MalteBastelt/Wecker/Dokumentation/Latex/Ollenschlaeger_Doku_Wecker.pdf

# DIY: Herstellung eines personalisierten Weckers mit Mikrocontroller und mp3-Player

Malte Ollenschläger

Zusammenfassung—Dieses Dokument beschreibt die Herstellung eines personalisierten Weckers. Das beinhaltet die Erstellung eines Gehäuses und das Schreiben der Software für den Mikrocontroller. Auch die Bauteilauswahl und die Fertigung von Platinen sind in diesem Projekt inbegriffen. Das Ziel ist einerseits die Fertigung des Weckers, andererseits die Durchführung eines Projektes mit verschiedenen Aufgabenbereichen, um das hierbei Gelernte, in folgenden Projekten zu einer effizienteren Arbeitsweise umzusetzen. Dies betrifft sowohl inhaltliche als auch formelle Arbeitsschritte.

I. ZIELSETZUNG
D

IE Gesamtfunktion des Weckers soll sich aus mehreren Teilfunktionen zusammensetzen. Eine der grundlegenden Funktionen ist die Anzeige der Uhrzeit auf einem Display. Weiterhin wird das Datum durch die Zusammensetzung des aktuelle Monats als Wort und des Tages als Ordinalzahl angezeigt. Für den Monat Februar sollen Schaltjahre berücksichtig werden. Ein weiteres Symbol gibt an, ob der Alarm einoder ausgeschaltet ist. Das De- beziehungsweise Aktivieren des Alarms geschieht durch das Gedrückthalten eines Tasters, über den gleichzeitig bei kurzem Drücken die die Beleuchtung eingeschaltet werden kann. Die Implementierung der Weckfunktion sorgt bei eingeschaltetem Alarm dafür, dass zur konfigurierten Uhrzeit der mp3-Player gestartet und eine sich auf selbigem befindliche mp3-Datei über die verbauten Lautsprecher wiedergegeben wird. Beim nächsten Weckruf wird die darauf folgende Datei abgespielt.
Über ein Menü, das über das Bedienen eines zweiten Tasters zu erreichen ist, sind folgende Elemente einstellbar:
- Uhrzeit
- Weckzeit
- Datum
- Lautstärke
- Boombox
Innerhalb des Menüs findet die Navigation über einen Drehencoder statt. Wird der Menüpunkt Boombox ausgewählt, so kann über ein Cinch-Kabel eine externe Audio-Quelle angeschlossen werden und die darauf abgespielte Musik wird über die Lautsprecher des Weckers wiedergegeben.
Die Personalisierung des Weckers wird durch drei Eigenschaften erreicht. Die erste ist die Tatsache, dass die Weckmusik nach dem eigenen Geschmack angepasst werden kann, indem diese auf den mp3-Player kopiert wird. Die zweite personalisierte Eigenschaft ist, dass beispielsweise an Valentinstag und am Geburtstag der Person statt des Datums andere Bilder oder Texte eingeblendet werden. Der offensichtlichste Teil der Personalisierung liegt in der Herstellung des Gehäuses. In die Front des Weckers werden Motive gelasert zu denen


Abbildung 1: Hierarchie der Elementaren Bauteile des Weckers. Die Pfeilspitze zeigt in die Datenflussrichtung. Blau unterlegt sind die für den Benutzer nicht zugänglichen Bauteile im Gehäuse. Die unterste Zeile zeigt die Ein- und Ausgabeebene, worüber der Benutzer mit dem Wecker interagiert.

die Benutzerin einen persönlichen Bezug hat. Diese werden zusätzlich zum Display beleuchtet, wenn der entsprechende Taster betätigt wird. Als Vorlage für dieses Projekt diente ein ebenfalls selbst hergestellter Wecker, der auf der Internetseite www.wiesolator.de vorgestellt wurde.
Alle im Rahmen dieses Projekts erstellten Dateien sind unter www.github.com/MalteBastelt/Wecker zu finden.

II. HARDWARE

Dieser Abschnitt befasst sich mit der gesamten Hardware des Weckers. Hierzu wird in Teil II-A beschrieben, welche Bauteile benötigt werden. Der sich anschließende Teil II-B befasst sich mit der externen Beschaltung der Bauteile. Es folgt ein Abschnitt über die Pinbelegung am Mikrocontroller in II-C. Abschnitt II-D beschreibt die Ansteuerung des mp3-Players. In II-E wird auf die Planung und Fertigung der Platinen eingegangen. Weiterhin erläutert II-F die Herstellung des Gehäuses.

A. Bauteile

Der Schaltplan, der im Vorlageprojekt genutzt wurde, dient als Anhaltspunkt für die Hardware, die benötigt wird. Daraus wurde das Schaubild in Abb. 1 erstellt, um eine Übersicht der wichtigsten Bauteile zu erhalten. Eine Auflistung aller benötigter Bauteile ist in Tabelle I aufgeführt. Die benötigten Widerstände und Kondensatoren sind nicht aufgeführt, da diese den Datenblättern der jeweiligen Bauteile zu entnehmen sind.

Funktionseinheit | Bezeichnung
Buchsenleiste | EBLG-20-1-X
Display | EA DOGL128W-6
Displaybeleuchtung | EA LED68x51-W
Drehencoder | STEC11B
Lautsprecher | Visaton FR8-8
Leuchtdioden | DLE-0000397
Mikrocontroller | Atmega328P
mp3-Player | Intenso Music Walker
Plexiglas
Schaltnetzteil 5V/1A | goobay 54805
Spannungsregler 1,5VDC | LM317
Spannungsregler 3,3VDC | LM3940
Spanplatten
Schrauben
Muttern
Taster | MS 131 SW
Transistor | BC547C
Transparenzfolie
Uhrenquarz 32kHz | -
Verstärker | TDA7266

Tabelle I: Benötigte Bauteile. Notwendige Kondensatoren und Widerstände sind nicht angegeben. Diese sind in den jeweiligen Datenblättern zu finden.

B. Dimensionierung
Grundsätzlich wurden die in den Datenblättern empfohlenen Kondensatoren und Widerstände eingesetzt. Zum Entprellen der Taster sind in den entsprechenden Datenblättern keine Informationen vorhanden. Es werden Keramikkondensatoren der Größe C = 100nF genutzt. Bei dem Spannungsregler für den mp3-Player (LM317) muss eine individuelle Dimensionierung vorgenommen werden, da der Ausgang des gewählten Spannungsreglers variable Spannungen erzeugen kann. Die benötigte Versorgungsspannung beträgt 1, 5V . Nach der im zugehörigen Datenblatt [1] angegebenen Formel, kann für eine gewünschte Ausgangsspannung die Größe der benötigten Widerstände berechnet werden. Somit ergibt sich die Größe von R2 nach folgender Gleichung:

R2 = ( Vout

Vref

− 1)/(

1
R1
+ Iadj ) | (1)

Für den Ausgleichsstrom wurden 50µA und damit die Hälfte des Maximums angenommen. Dieser wird vom Spannungsregler so geregelt, dass Vref = 1, 25V gilt. Bei einer Wahl von R1 = 10kΩ ergibt sich für R2 ≈ 1, 3kΩ.
Zur Beleuchtung der beiden Bilder auf der Frontseite des Weckers wird je Bild eine Transistorschaltung (Abb. 2) benötigt. Diese wird durch ein Kontrollsignal vom Mikrocontroller, welches an die Basis des Transistors angeschlossen ist, gesteuert. Ein BC547C Transistor schaltet vier LEDs. Der Kollektorstrom von IC ist das Vierfache des Vorwärtsstroms einer LED IF = 20mA [2]:
IC = 4 · IF | (2a)
IC = 4 · 20mA = 80mA | (2b)


Abbildung 2: Transistorschaltung zur Ansteuerung von LEDs

Dies folgt aus der ersten Kirchhoff’schen Regel, wonach sich der Kollektorstrom gleichmäßig auf die vier LEDs aufteilt. Die Berechnung der Widerstände ergibt sich aus folgen Formeln:

RBasis ≤

UµC − UBE
IB

=

3, 3V − 0, 66V
5mA | ≈ 528Ω | (3)

RKollektor =

Ucc − ULED − UCE
IC

=

5V − 3, 6V − 0, 2V
80mA | ≈ 15Ω

(4)

Da der Mikrocontroller eine Versorgungsspannung von 3, 3V hat, ist das Steuersignal UµC ebenso groß. Die Basis-Emitter-Spannung UBE und die Kollektor-Emitter-Spannung UCE sowie der Basisstrom IB sind dem Datenblatt des BC547C entnommen [3]. Entsprechendes gilt für die an den LEDs abfallende Spannung. Nach den Berechnungen in den Gleichungen (2) bis (4) wurde der Basiswiderstand zu 440Ω und der Kollektorwiderstand zu 15Ω gewählt.

C. Pinbelegung Mikrocontroller

Da es für den Oszillator keine Auswahlmöglichkeiten bezüglich der Pinbelegung gibt, wurden ihm als erstes die entsprechenden Pins am Mikrocontroller zugewiesen. Hierfür ist kein Datenblatt vorhanden, weil er im Einzelhandel ohne exakte Artikelbeschreibung gekauft wurde. Die Pins für den Anschluss des Displays wurden so gewählt, dass alle nebeneinander liegen, damit das Layout der Platine erleichtert wird und lediglich gerade Leiterbahnen zwischen den Pins des Mikrocontrollers und dem betreffenden Steckverbinder erstellt werden müssen. Gleiches gilt für die Belegung der Pins zur Ansteuerung des mp3-Players.
Die Auswahl für die Belegung der Taster unterliegt lediglich der Einschränkung, dass die Taster (Licht und Drehencoder) einem anderen Interrupt zugeordnet werden als eine Drehung des Drehencoders. Dies führt zu einer vereinfachten Auswertung der Drehrichtung, siehe Abschnitt III-B.

Display | USB

3,5 mm Klinke On/Play

1
2
3

4
5
6

Abbildung 3: Pinbelegung mp3-Player

D. Ansteuerung mp3-Player

Um ein Bild davon zu bekommen, wie die Steuerung des mp3-Players funktioniert, wurde dieser zunächst aus seinem Gehäuse ausgebaut. Durch Testen wurde die Funktionsweise der benötigten Taster simuliert. In Abb. ?? ist eine Zeichnung des mp3-Players dargestellt, die zum näheren Verständnis des folgenden Textes herangezogen werden kann.
Der silberne Steuerknopf hat auf zwei gegenüberliegenden Seiten je 3 Kontakte. Darüber liegt rings um diesen Knopf unterhalb der Plastikabdeckung eine Massefläche. Wird der Knopf in eine bestimmte Richtung bewegt, so wird einer der 6 Pins auf Masse gezogen und daraus resultiert ein Steuersignal. Welches Ereignis durch die verschiedenen Pins ausgelöst wird, ist in Tabelle II dokumentiert. Zur Betätigung des Ein- und Ausschalters, der bei kurzem Drücken für Play/Pause genutzt wird, muss eine bestimmte der vier daran befindlichen Lötstellen auf das Level 1, 5V gehoben werden. Zwei Lötstellen befinden sich auf der Oberseite und zwei in Richtung Mitte der Platine. Von letzteren muss die Lötstelle, welche in Richtung der 3, 5mm-Klinken-Buchse liegt, auf 1, 5V angehoben werden. Um das 3, 3V Schaltsignal des Mikrocontrollers auf 1, 5V für den mp3-Player zu verringern, wurden 3 Dioden vom Typ 1N4448 in Reihe zwischen den Ausgang des Mikrocontrollers und den betreffenden Konnektor zum mp3-Player geschaltet. Über den Dioden fällt jeweils etwa 0, 6V ab, sodass 3, 3V − 3 · 0, 6V = 1, 5V an dem Taster anliegen, wenn der Pin des Mikrocontrollers auf 3, 3V gesetzt ist. Die Versorgungsspannung des mp3-Players wird über einen 1, 5V -DC/DC Spannungsregler zur Verfügung gestellt.
Pin | Level | Ereignis
1 | 0V | Song wechseln
3 | 0V | Lautstärke -
4 | 0V | Lautstärke +
On-1 | 1,5V | Ein/Aus, Play/Pause

Tabelle II: Tastenkombination für Auslösung verschiedener Ereignisse. Funktion von On-1 je nach Betätigungsdauer (lang,kurz).

E. Platinen

Die für dieses Projekt benötigten Platinen wurden mit KiCAD geplant und anschließend im FabLab der Friedrich-Alexander-Universität Erlangen-Nürnberg erstellt. Die erste Platine konnte nicht verwendet werden, da das ausgedruckte Layout nicht den tatsächlichen Dimensionen entsprach. Die

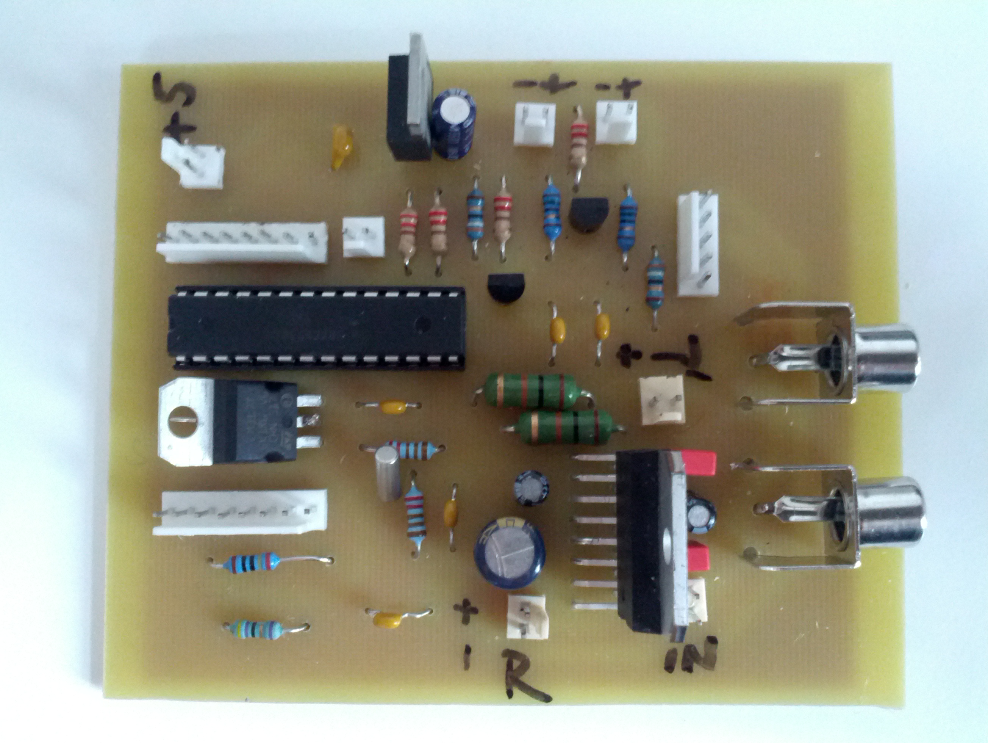
[picture p5: figure]

Abbildung 4: Hauptplatine.

Ursache hierfür liegt vermutlich im Export des Schaltplans in eine PDF-Datei. Korrekte Maße bleiben nur Erhalten, wenn in eine PostScript-Datei anstatt in ein PDF exportiert wird. Eine Platine ist für das Display und die zugehörigen Bauelemente (Kondensatoren, Widerstände) ausgelegt. Über einen Steckverbinder kann diese Platine mit der Hauptplatine verbunden werden, welche die anderen Bauelemente wie zum Beispiel den Mikrocontroller und den Audio-Verstärker enthält.
Für die Displayplatine wurden die Anschlüsse des Displays nicht direkt auf der Platine verlötet. Es wurden Buchsenleisten verlötet in welche das Display samt verlöteter Hintergrundbeleuchtung eingesteckt wird. Dies dient einerseits dazu, dass das Display zum Wechsel oder zur Reparatur ausgebaut werden kann; andererseits dazu, dass der Abstand zwischen Gehäuseinnenseite und Platine vergrößert wird. Dies ist notwendig, damit der Drehencoder, welcher auf der Platine befestigt wird, nicht zu weit nach vorne aus dem Gehäuse herausragt. Außerdem dient es der Herstellung einer kraftschlüssigen Verbindung zwischen Display und Gehäuse (siehe II-F). Für die Erstellung der Platine wurde eine Leiterbahnbreite von 0, 5mm gewählt, da genug Fläche vorhanden war.
Für die Hauptplatine wurde ebenfalls eine Leiterbahnbreite von 0, 5mm gewählt. Neben der Displayplatine wurden weitere Bauelemente per Steckverbinder mit der Hauptplatine verbunden. Diese sind:
- Lautsprecher
- Taster
- Drehencoder
- LED-Beleuchtung (Bilder)
- mp3-Player
Abbildung 4 zeig die bestückte Hauptplatine. Zur Identifikation der Bauteile können die in KiCAD erstellten Dokumente genutzt werden, die sich im GitHub-Verzeichnis befinden.
F. Gehäuse

In die vier Ecken der Platine werden Löcher gebohrt, ebenso im gleichen Abstandsmaß in die Front des Weckers. Anschließend kann die Platine per Schraube und Mutter von innen gegen das Gehäuse gedrückt werden, sodass das Display fixiert ist und durch die rechteckige Öffnung in der Front des Gehäuses betrachtet werden kann.

III. SOFTWARE

Um die gewünschten Inhalte auf dem LCD-Display anzuzeigen, müssen diese Elemente zunächst generiert werden. Dies geschah mittels Inkscape. Anschließend wurden diese Inhalte einen selbst geschriebenen Java-Programm zugeführt, welches in Abschnitt III-A beschrieben wird. Der zweite Abschnitt befasst sich mit dem umfangreicheren Code, der auf dem Mikrocontroller eingesetzt wird.

A. Bildkonversion

Für die Entwicklung eines Bildkonverters in Java wurde Eclipse genutzt. Ziel ist die Umwandlung von grafischen Dateien in Binärcode, also ein monochrom Bild. Anschließend sollen jeweils 8 Binärwerte/Pixel zu einer Hexadezimalzahl zusammengefasst werden.
Zunächst werden Dateien mit einzelnen Buchstaben, Symbolen und Bildern in Inkscape erstellt. In Schriftgröße 18 gibt ein zentrierter Großbuchstabe J die vertikale Position aller weiteren Buchstaben vor, da dies der höchste Buchstabe ist. Die erstellte Grafik wird als *.png exportiert und dem Java-Programm zugeführt. Dieses trägt den Namen Bildkonverter. Wird es geöffnet, sind drei Buttons und ein Eingabefeld zu sehen. Über Datei wählen wird das zu verarbeitende Bild ausgewählt. Die Umwandlung startet durch Klicken des entsprechenden Buttons. Zunächst wird durch Auswertung des Rotkanals jedes Pixels ein Binärwert erzeugt. Ist der Wert des Rotkanals größer oder gleich der angegebene Schwelle, so wird das entsprechende Pixel gesetzt. Ist es geringer als der Schwellwert, wird dieser Pixel auf null gesetzt. Anschließend werden jeweils 8 aufeinander folgende Pixel einer Spalte zu einem Hexadezimalwert zusammengefasst, um das Handling zu erleichtern. Wenn ein Bild eine Höhe von 16px hat und eine Breite von 3px, so werden 3 Mal zwei Hexadezimalwerte erzeugt. Diese sechs Werte werden in geschweiften Klammern ausgegeben, damit diese in einem Alphabet-Array im Code für den Mikrocontroller gespeichert werden können. Weiterhin wird eine Vorschau des Binärbildes angezeigt. So müssen die Daten nicht erst auf den Mikrocontroller überspielt und am LCD-Display angezeigt werden, um Fehler zu erkennen. Diese können beispielsweise durch Änderung des Schwellwertes oder durch das Setzen oder Löschen einzelner Pixel in dem Bild mittels Bildbearbeitungssoftware (zum Beispiel Paint) korrigiert werden. Zum Beenden des Konverters dient der Button Schließen. Die Ausgabe befindet sich nun in einer Datei mit dem Namen Konverter-output.txt in dem Ordner, in dem das Java-Programm gestartet wurde.
B. Atmel-Code

Der Code für den Mikrocontroller wurde zunächst in AtmelStudio 6.1 und anschließend in AtmelStudio 7.0 erstellt. Er setzt sich aus verschiedenen Dateien zusammen. Die Hauptaufgabe übernimmt eine Endlosschleife in der Main-Funktion der Datei EADOGL128.c. In EADOGL128_commands.c wurden die Befehle zur Ansteuerung des LCD-Displays implementiert. Um den mp3-Player und den Audio-Verstärker anzusprechen, werden die in mp3.c erstellten Funktionen genutzt. Nicht selbst geschriebener Code wurde in Form von Standardbibliotheken wie avr/io.h genutzt sowie in der Datei sbit.h [4], welche es ermöglicht, Pins wie Variablen ansprechen zu können.
EADOGL128.c: | Es | gibt | mehrere | Interrupt-Service-
Routinen, die Einfluss auf die ausgeführten Aktionen in der Main-Funktion nehmen. Im Normalzustand befindet sich der Mikrocontroller im sleep-Modus. Um in diesen einzutreten sind einige Vorbereitungen notwendig, die in der Funktion goodNight() implementiert sind. Das Verlassen des sleep-Modus geschieht durch eines von mehreren möglichen Interrupts. Hierzu zählen die Bedienung des Drehencoders und des Tasters sowie ein Timer-Overflow aufgrund der Zeitmessung mittels Uhrenquarz. Dieser Overflow findet ein Mal pro Sekunde statt. Wenn sich auf dem LCD-Display durch das Zeit-Update nichts ändern muss (Sekunde<60), wird der sleep-Modus erneut aktiviert.
Im Falle einer Benutzereingabe oder eines notwendigen Updates des LCD-Displays, wird die Funktion goodNight verlassen und das betreffende Ereignis wird abgearbeitet. Danach tritt der Mikrocontroller erneut in den sleep-Modus ein. Interrupt-Service Routinen (ISR):
Die ISR(PCINT0_vect) wird bei Interrupts an den Interrupt-Pins PCINT0 bis PCINT7 aufgerufen. Hierin wird überprüf, ob der Drehencoder oder der Taster gedrückt wurde und es wird entsprechende Flag auf true gesetzt. Somit wird zum Beispiel das Einschalten des Lichts in der main-Funktion eingeleitet. Würde die Drehung des Drehencoders im gleichen Interrupt erfasst werden, so müsste der letzte bekannte Status des Drehencoders gespeichert werden, damit überprüft werden kann, ob eine Änderung stattgefunden hat, oder lediglich ein Taster bedient wurde. Durch die Zuweisung der Signale, die bei einer Drehung verändert werden an eine andere ISR (PCINT2_vect), kann dieser Schritt eingespart werden. Die ISR (PCINT2_vect) vergleicht den Status der beiden betreffenden Signale. Die Drehrichtung lässt sich daraus ermitteln, ob beide Signale gleich

Status(P INA) = Status(P INC) = (high Y low) (5)

oder unterschiedlich

Status(P INA) 6= Status(P INC) | (6)

sind [5]. Je nach Ergebnis dieses Vergleichs wird bei einer detektierten Rechtsdrehung eine Zählvariable inkrementiert sowie bei Linksdrehung dekrementiert. Diese muss bei Abruf auf null zurückgesetzt werden.
Bei eingeschalteter Beleuchtung bewirken alle Benutzereingaben eine Verlängerung der Leuchtdauer so, als ob der Taster für die Beleuchtung zu diesem Zeitpunkt betätigt wurde. Die dritte ISR(TIMER2_OVF_vect) wird aufgerufen, wenn ein Overflow in dem vom Uhrenquarz getakteten Counter stattfindet. Da ein 8-bit Timer mit einem Prescaler von 128 zum Inkrementieren des Counters genutzt wird, und der Quarz mit einer Frequenz von 32768 Hz schwingt, findet dieser

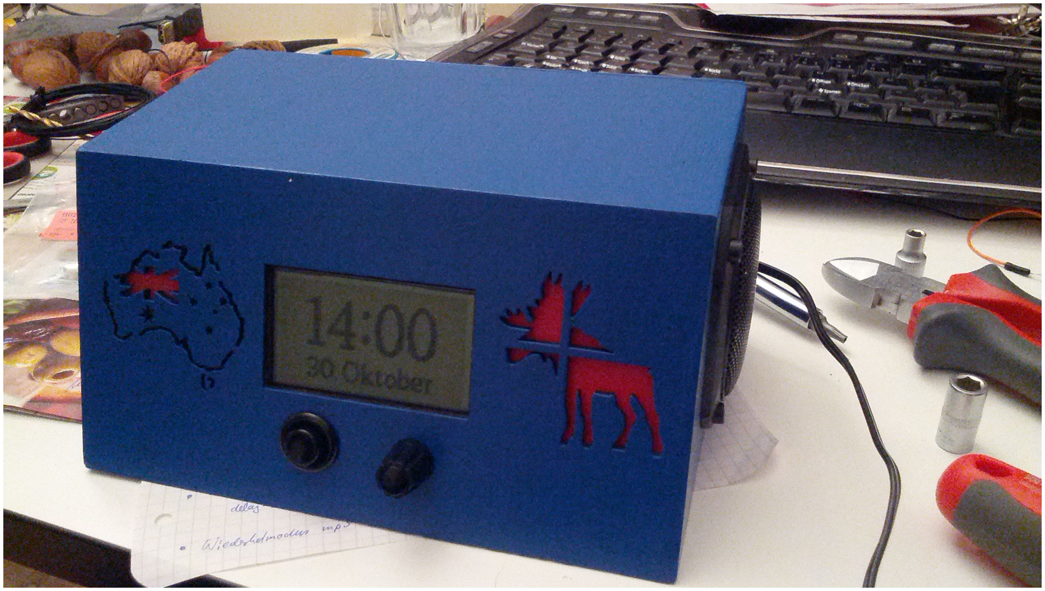
[picture p6: figure]

Abbildung 5: Wecker bei ausgeschalteter Beleuchtung

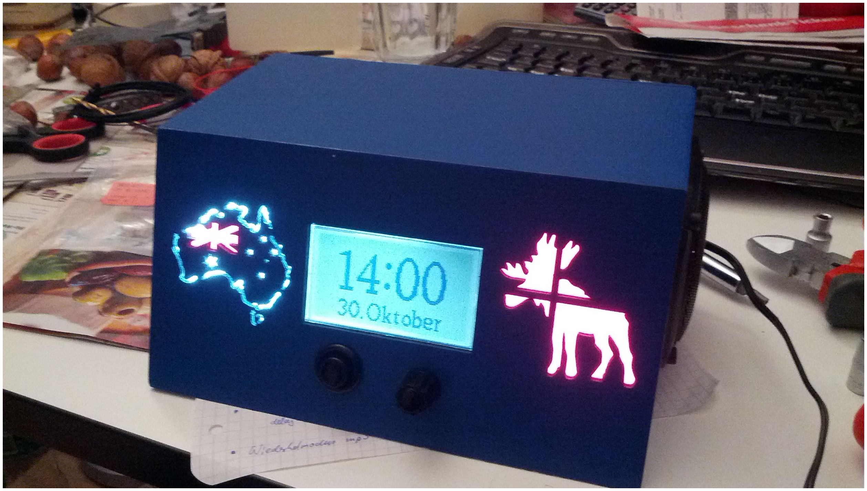
[picture p7: figure]

Abbildung 6: Wecker bei eingeschalteter Beleuchtung

Overflow ein Mal pro Sekunde statt. Hierbei wird die Variable sekunde um eins inkrementiert. Wenn diese Variable den Wert 59 übersteigt, wird ein Flag gesetzt, welches das Update der Minute und gegebenenfalls der Stunde sowie des Datums in der main-Funktion einleitet.
Eine vierte ISR(TIMER0_OVF_vect) wird genutzt um die Dauer eines Tastendrucks zu ermitteln. Dieser Timer kann mit der Funktion start_btnPress() aktiviert werden und mit stop_btnPress gestoppt werden. Die Dauer des Tastendrucks ist dann in der globalen Variablen btn_press_duration gespeichert und kann ausgelesen werden. Bei langem Drücken des Drehencoders wird das Menü aufgerufen. Weiterhin ermöglich dies, dass der Taster für das Licht bei kurzem Drücken zum Einschalten der Beleuchtung und bei langem Drücken zum Ein-/Ausschalten des Alarms führt.

IV. BEDIENUNG

Die Abbildungen 5 und 6 zeigen den erstellten Wecker. Unterhalb des Displays befindet sich rechts der Drehencoder und links der Taster. An der rechten Seite des Gehäuses ist ein Lautsprecher zu erkennen, ein identischer Lautsprecher ist auf der linken Seite verbaut.

A. Alarm
Um den Alarm ein- oder auszuschalten wird der Taster für mindestens 1, 5s gedrückt. Ausschalten des Alarms sowie stoppen des Weckrufs geschieht durch Betätigung des Tasters von 1, 5s oder mehr. Während des Weckrufs ist es außerdem möglich, in den snooze-Modus zu wechseln. Dies geschieht durch kurzes Drücken des Tasters oder Drehen des Drehencoders. Ein erneuter Weckeruf wird nach der im Menü eingestellten Snoozedauer (in Minuten) gestartet. Erneutes snoozen ist nicht möglich und der Weckruf muss über ein 1, 5-sekundiges Drücken des Tasters ausgeschaltet werden.
B. Menü
Das Menü kann über ein langes Drücken des Drehencoders aufgerufen werden. Navigiert wird über die Drehung desselben. Soll ein Punkt im Menü aufgerufen wird, so muss die Auswahl durch kurzes Drücken auf den Drehencoder getätigt werden. In Untermenüs wie beispielsweise der Uhrzeiteinstellung wird ebenfalls durch eine Drehung navigiert. Soll zum Beispiel die Stunde verändert werden, muss die Markierung über das entsprechende Element navigiert werden. Nach einer Bestätigung durch erneut kurzes Drücken ändert sich das Navigationssymbol und die Stunde der Uhrzeit kann verändert werden. Durch erneutes Drücken des Drehencoders wird dieser Modus verlassen. Das Untermenü kann über den angezeigten Haken verlassen werden.
C. Lautstärke
Für die Einstellung der Lautstärke des Weckrufs muss der entsprechende Unterpunkt im Menü aufgerufen werden. Daraufhin werden Verstärker und mp3-Player eingeschaltet. Letzterer benötigt etwa zehn Sekunden. Während dieser Zeit erscheint der Schriftzug „Bitte warten“. Die Musik geht an und anstatt des Schriftzugs erscheint ein Lautsprecher-Symbol. Die Lautstärke kann nun mittels Drehencoder verstellt werden.
D. Boombox
Bei Auswahl des Menüpunktes Boombox, wird der Verstärker eingeschaltet. Nun kann über die Cinch-Buchsen und ein entsprechendes Kabel (z.B. 3, 5mm-Klinke ↔ Cinch) eine externe Audioquelle wie ein Handy oder Laptop angeschlossen werden. Dessen Audiosignal wird dann über die Lautsprecher wiedergegeben.

LITERATUR

[1] 1.2 V to 37 V adjustable voltage regulators, STMicroelectronics
Data Sheet 2154, Rev. 19, Mär. 2014. [Online]. Available: http://www.st.com/web/en/resource/technical/document/datasheet/CD00000455.pdf
[2] 334-15/X2C1-1UWB, | Everlight | Technical | Data | Sheet,
Rev. | 2, | Nov. | 2008. | [Online]. | Available: | http://cdn-
reichelt.de/documents/datenblatt/A500/334-15-X2C1-1UWB.pdf
[3] SMALL | SIGNAL | NPN | TRANSISTORS, | STMicroelec-
tronics | | Std., | Jan. | 2003. | [Online]. | Available:
http://pdf.datasheetcatalog.com/datasheet/stmicroelectronics/8854.pdf
[4] AvrFreaks. | (2015, | Dezember) | Sbit.h. | [Online]. | Available:
http://www.avrfreaks.net/sites/default/files/SBIT.H
[5] 11mm Size Metal Shaft Type, ALPS Datasheet. [Online]. Available: http://cdn-reichelt.de/documents/datenblatt/B400/STEC11B.pdf
V. FAZIT
Bei der Erstellung des PCB-Layouts wurde zu Beginn nicht durchgängig die Anordnung der Bauteile auf dem Schaltplan beachtet. Somit kommt es zu viele Kreuzungen der Leiterbahnen. Eine Vorsortierung in Bauteilgruppen erleichtert das Routing und ist deshalb ratsam.
