MalteBastelt/Wecker/Dokumentation/Latex/Grafiken/mp3Player-eps-converted-to.pdf

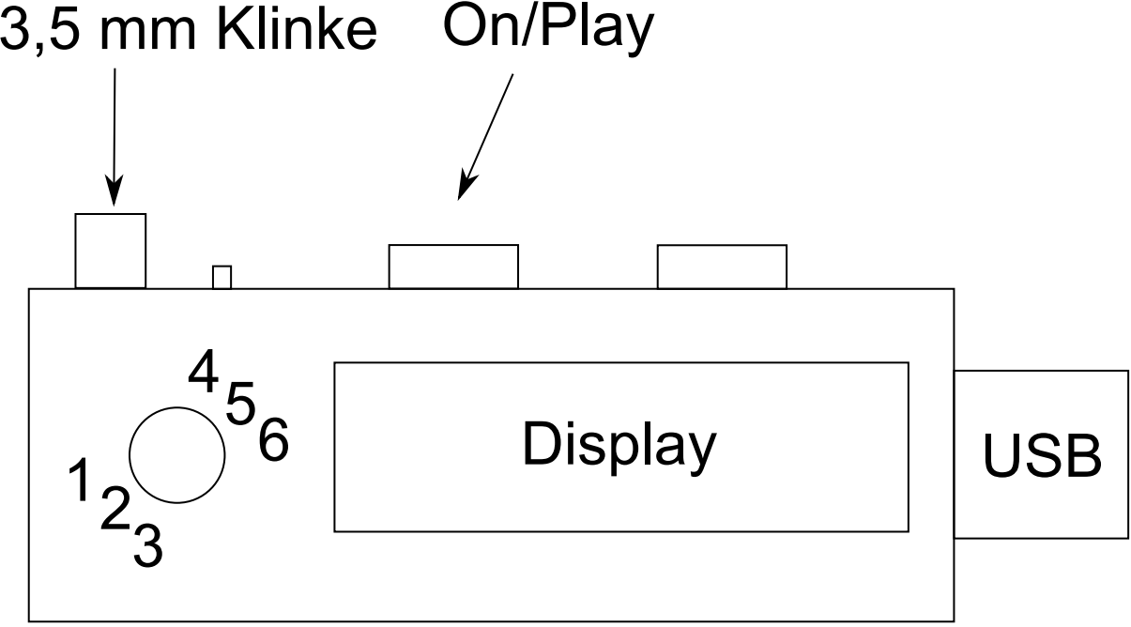
[picture p8: figure]
Display; USB; 3,5 mm Klinke On/Play
