MalteBastelt/Wecker/Bildkonverter/links.bmp

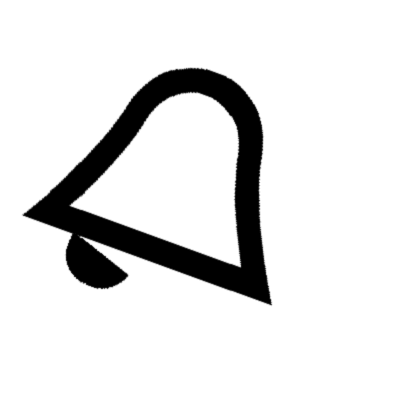
Bildkonverter/links.bmp
