MalteBastelt/Wecker/Bildkonverter/rechts.bmp

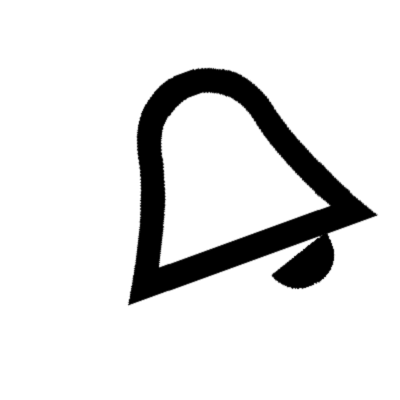
Bildkonverter/rechts.bmp
