MalteBastelt/Wecker/Bildkonverter/rose1.gif

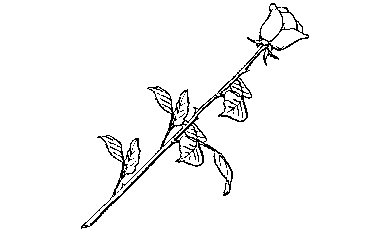
Bildkonverter/rose1.gif
