MalteBastelt/Wecker/Bildkonverter/rose2.jpg

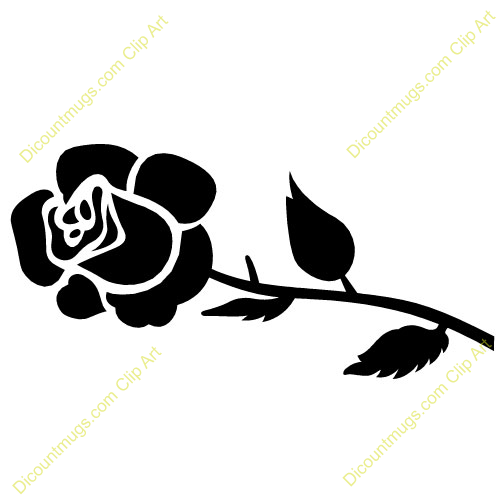
Bildkonverter/rose2.jpg
