MalteBastelt/Wecker/Bildkonverter/rose3.1.png

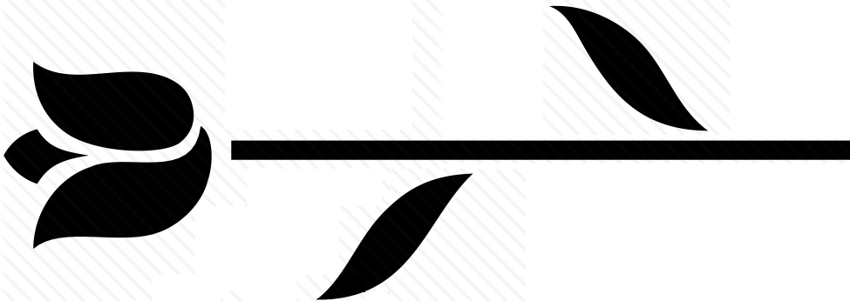
Bildkonverter/rose3.1.png
