MalteBastelt/Wecker/Bildkonverter/rose3.png

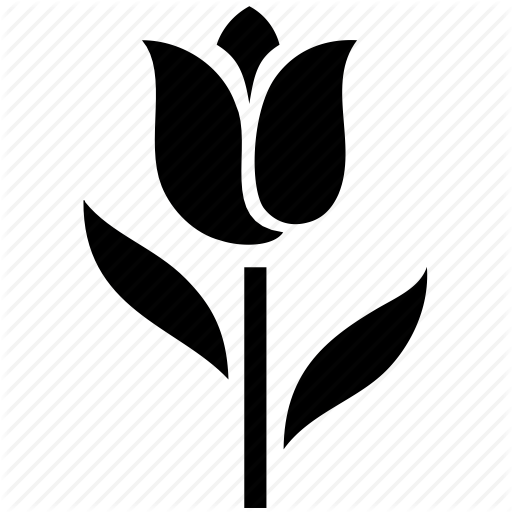
Bildkonverter/rose3.png
