MalteBastelt/Wecker/Dokumentation/Latex/Grafiken/mp3Player.png

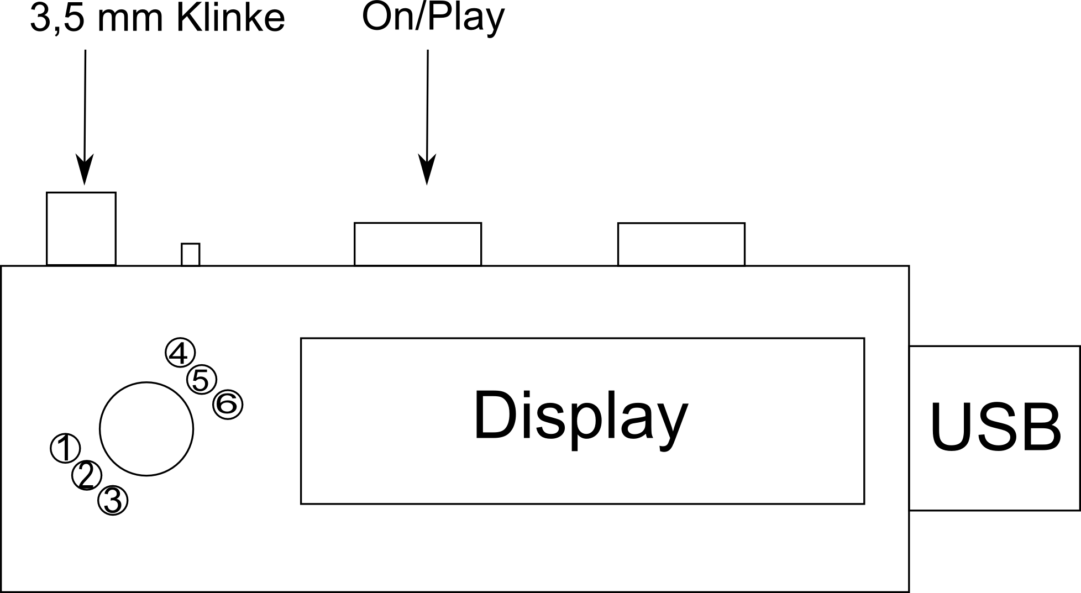
Dokumentation/Latex/Grafiken/mp3Player.png
