MalteBastelt/Wecker/KiCAD/Hauptplatine2/Wecker-B.Cu.pdf

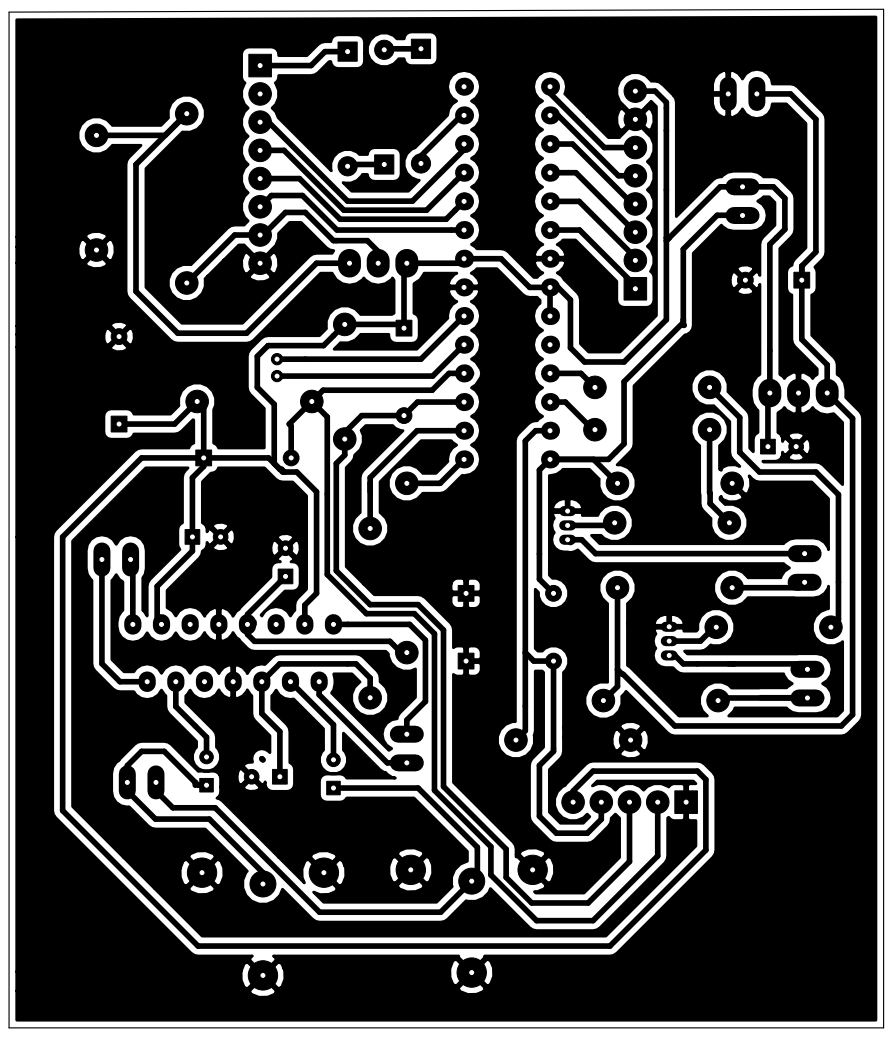
[picture p16: page 1]
