MalteBastelt/Wecker/KiCAD/Hauptplatine2/Wecker-F.Cu.pdf

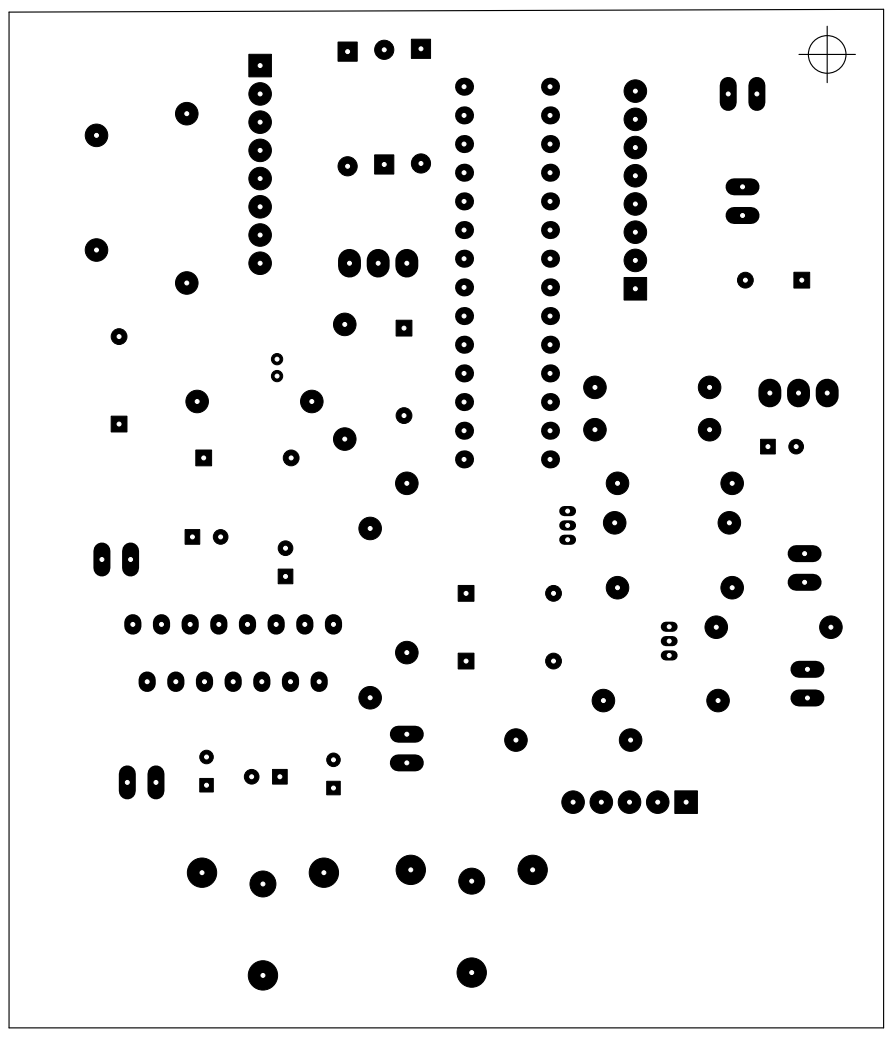
[picture p17: page 1]
