MalteBastelt/Wecker/KiCAD/Hauptplatine2/Wecker-F.SilkS.pdf

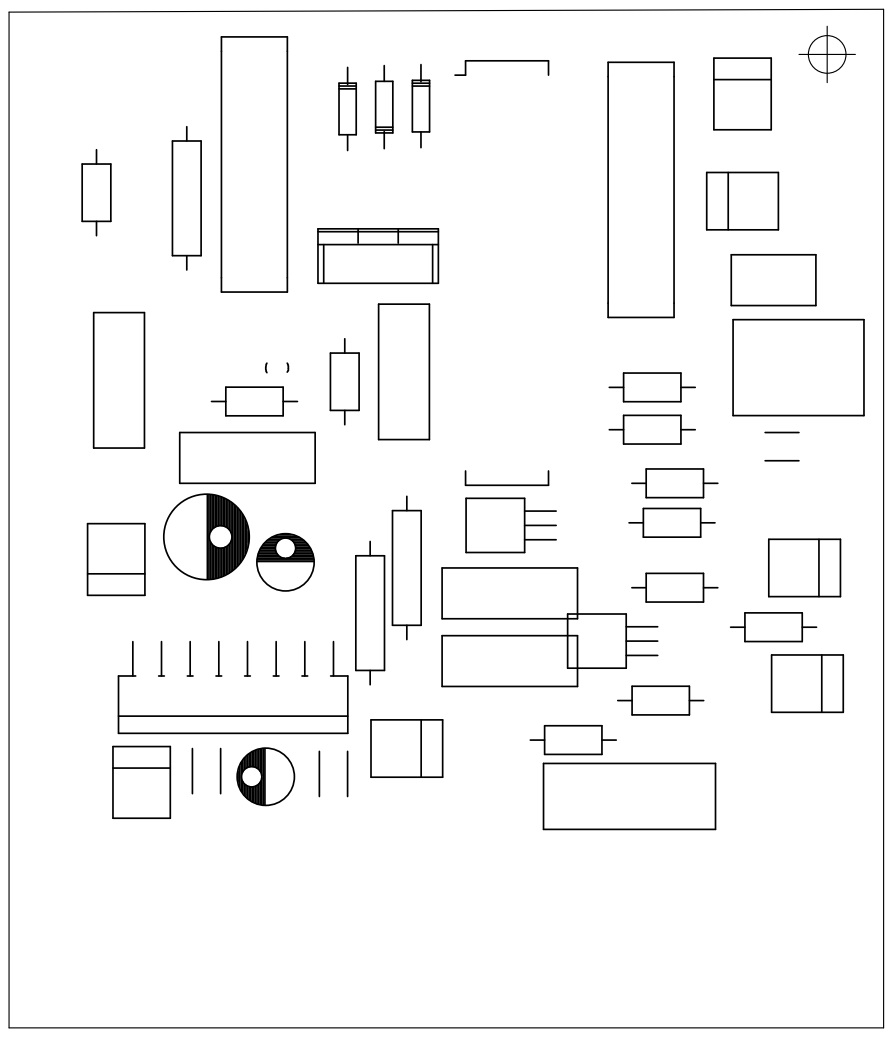
[picture p18: page 1]
