MalteBastelt/Wecker/KiCAD/Displayplatine/Display.kicad_pcb

## KiCad design KiCAD/Displayplatine/Display.kicad_pcb (2015-12-03)

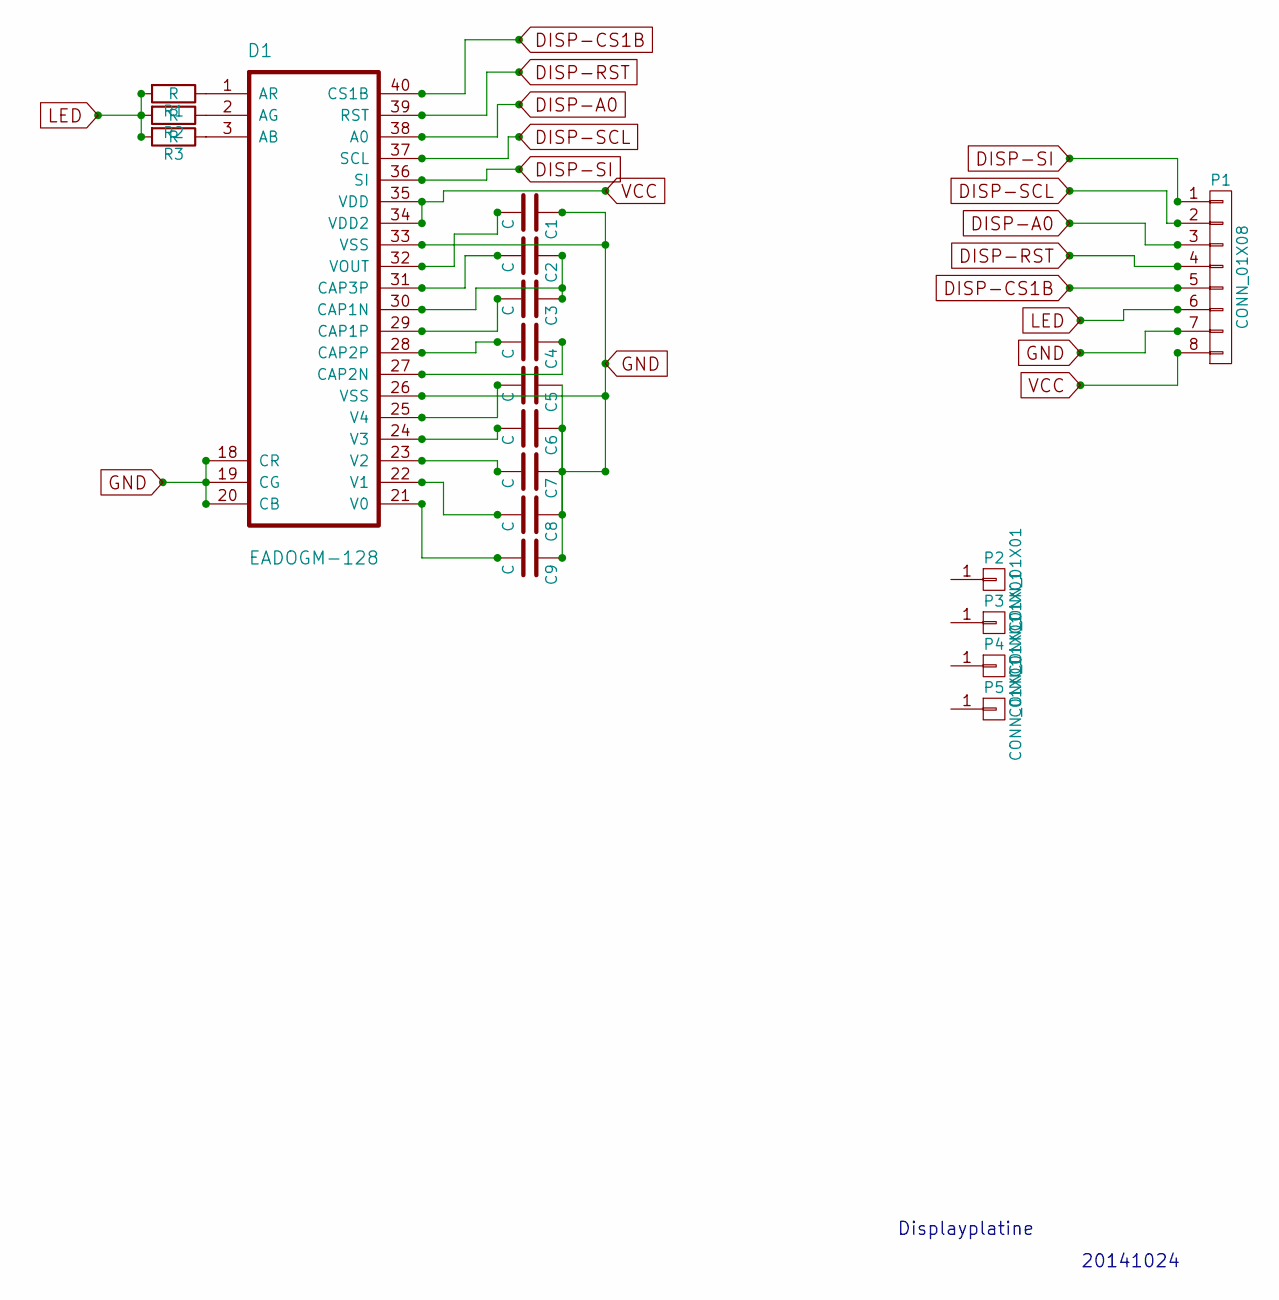
[picture p19: schematic Display.sch]

Parts:
C1, C2, C3, C4, C5, C6, C7, C8, C9: C; C_Disc_D7.5_P5
D1: EADOGM-128; EADOG128
P1: CONN_01X08; Pin_Header_Straight_1x08
P2, P3, P4, P5: CONN_01X01; Pin_Header_Straight_1x01
R1, R2, R3: R; Resistor_Horizontal_RM10mm

Connections:
D1: D1.36 (SI), P1.1
D2: D1.37 (SCL), P1.2
D3: D1.38 (A0), P1.3
D4: D1.39 (RST), P1.4
D5: D1.40 (CS1B), P1.5
GND: C1.1, C5.1, C6.1, C7.1, C8.1, C9.1, D1.18 (CR), D1.19 (CG), D1.20 (CB), D1.26 (VSS), D1.33 (VSS), P1.7
LED: P1.6, R1.2, R2.2, R3.2
unnamed: C1.2, D1.32 (VOUT)
unnamed: C2.1, C3.1, D1.30 (CAP1N)
unnamed: C2.2, D1.31 (CAP3P)
unnamed: C3.2, D1.29 (CAP1P)
unnamed: C4.1, D1.27 (CAP2N)
unnamed: C4.2, D1.28 (CAP2P)
unnamed: C5.2, D1.25 (V4)
unnamed: C6.2, D1.24 (V3)
unnamed: C7.2, D1.23 (V2)
unnamed: C8.2, D1.22 (V1)
unnamed: C9.2, D1.21 (V0)
unnamed: D1.1 (AR), R1.1
unnamed: D1.2 (AG), R2.1
unnamed: D1.3 (AB), R3.1
VCC: D1.34 (VDD2), D1.35 (VDD), P1.8

Notes on the sheet:
Displayplatine
20141024

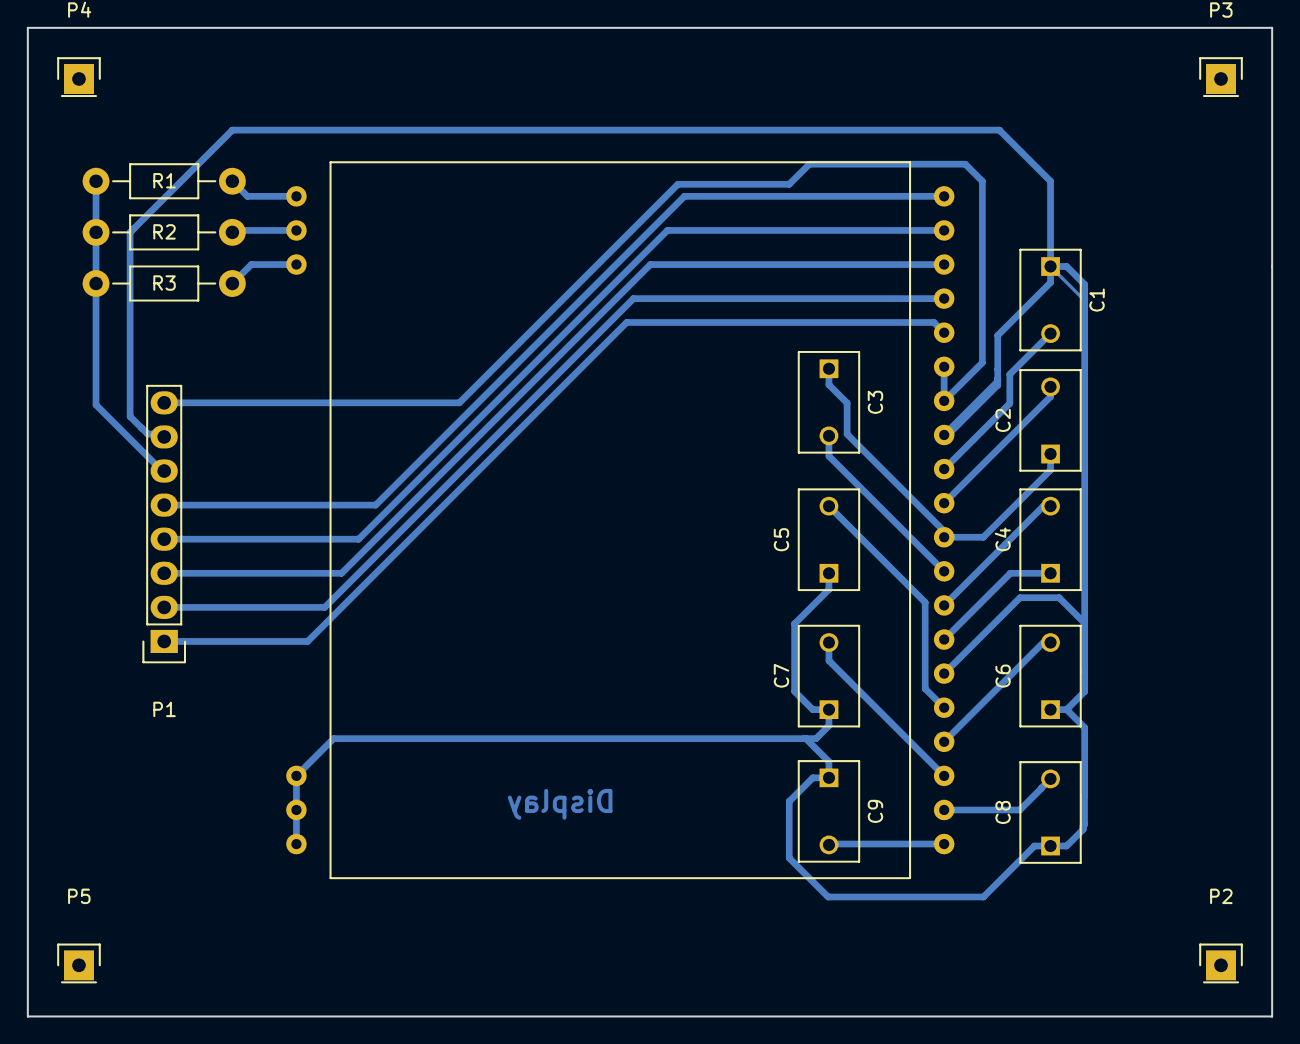
[picture p20: board Display.kicad_pcb from above]

Board: 2 copper layers, 92.7 x 73.7 mm, 18 parts (0 on the bottom side), 22 nets.
