MalteBastelt/Wecker/KiCAD/Hauptplatine2/Wecker.kicad_pcb

## KiCad design KiCAD/Hauptplatine2/Wecker.kicad_pcb (2015-12-03)

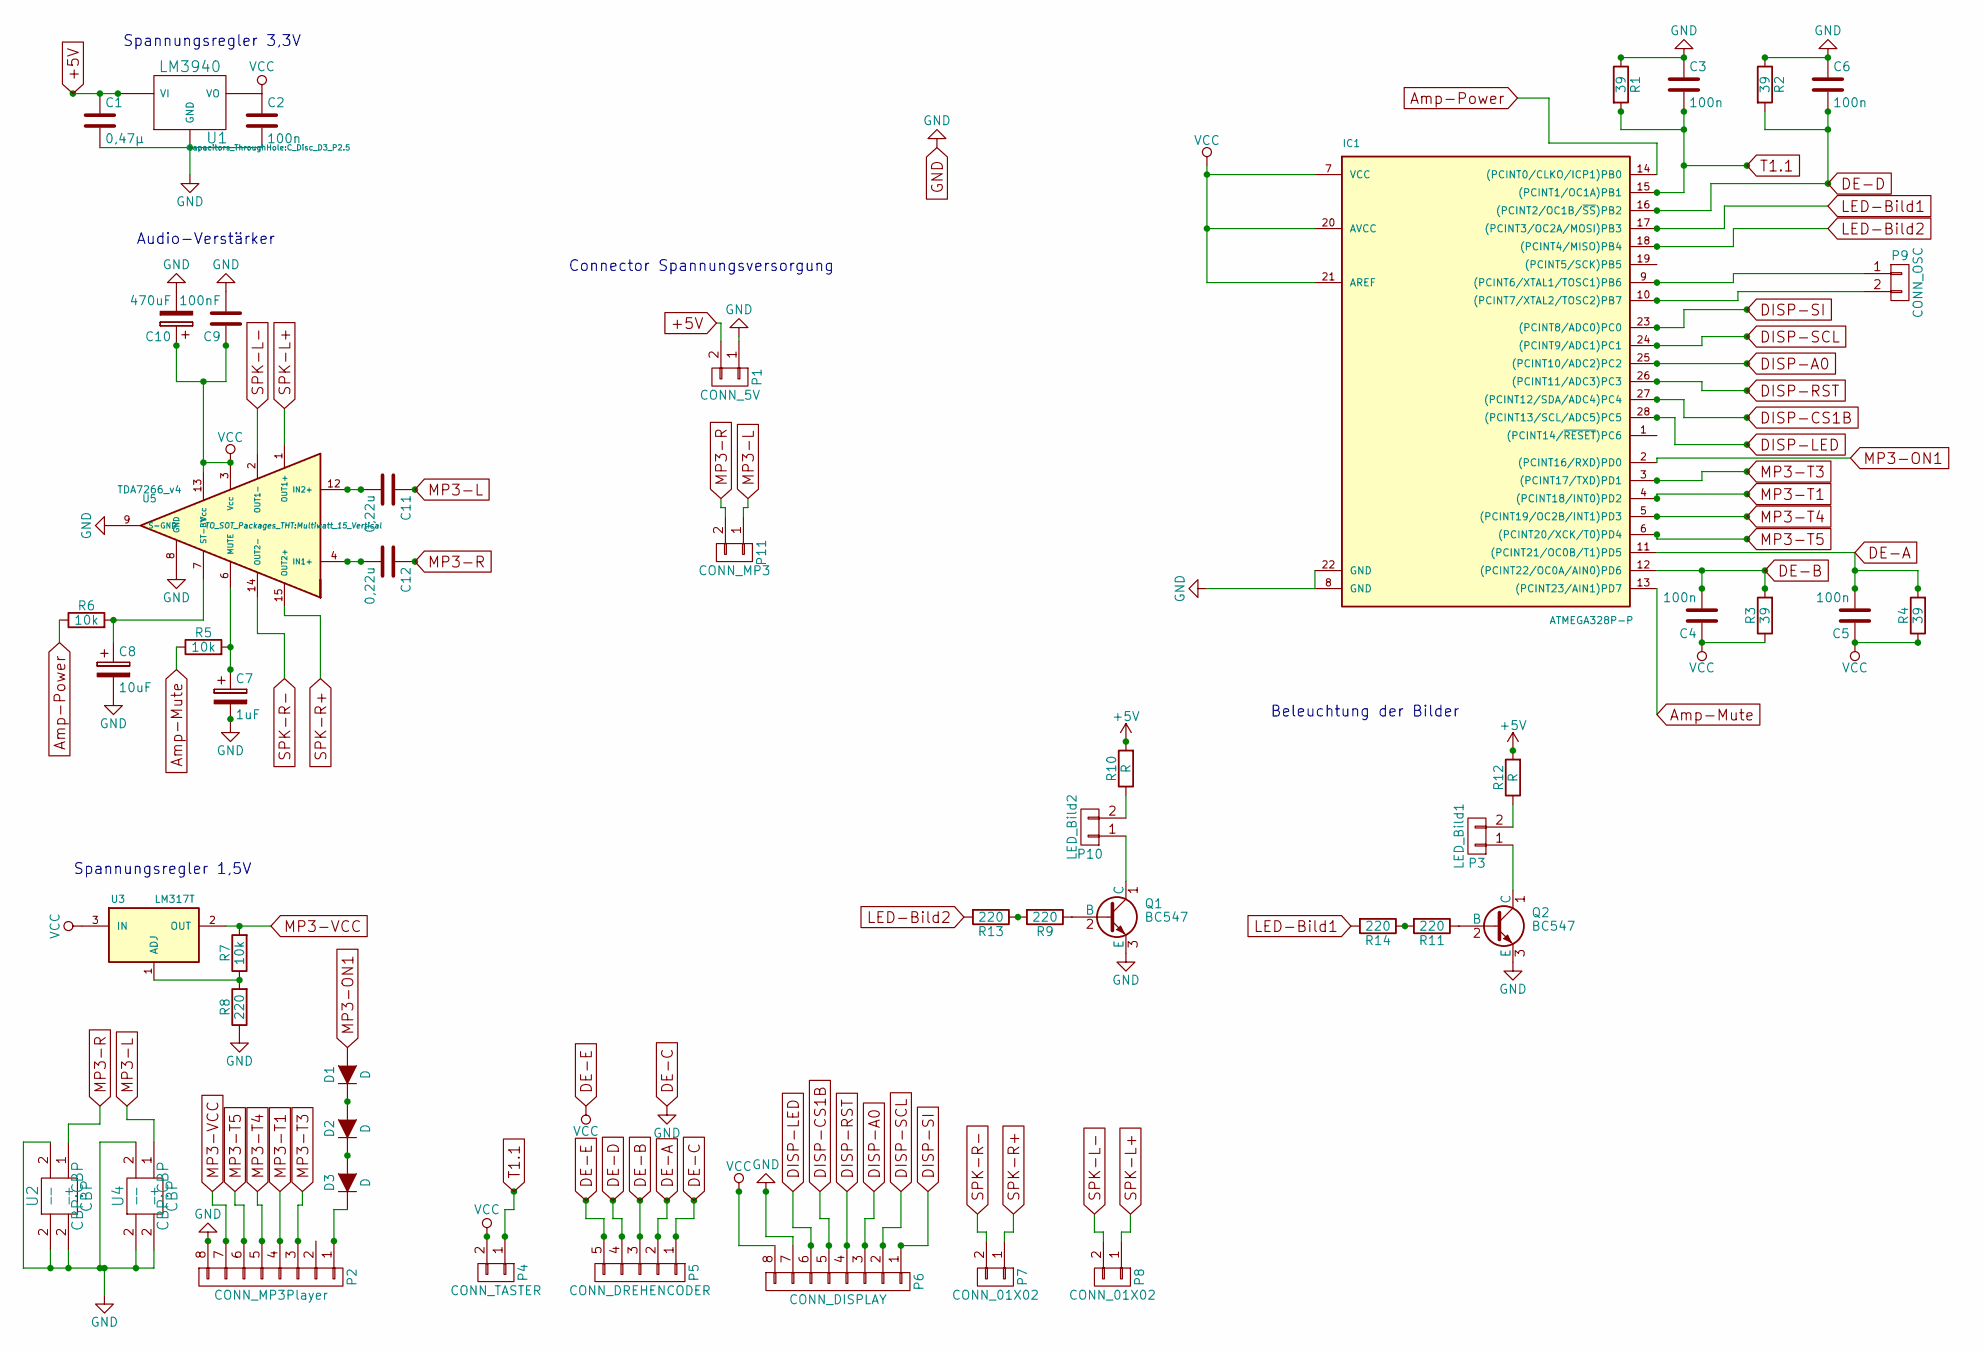
[picture p21: schematic Wecker.sch]

Parts:
C1: 0,47µ; C_Disc_D7.5_P5
C2: 100n; C_Disc_D3_P2.5
C3, C4, C5, C6: 100n; C_Disc_D12_P7.75
C7: 1uF; C_Radial_D5_L6_P2.5
C8: 10uF; C_Radial_D5_L6_P2.5
C9: 100nF; C_Disc_D12_P7.75
C10: 470uF; C_Radial_D7.5_L11.2_P2.5
C11, C12: 0,22u; C_Rect_L4_W2.5_P2.5
D1, D2, D3: D; Diode_DO-35_SOD27_Horizontal_RM10
IC1: ATMEGA328P-P; DIP-28_W7.62mm
P1: CONN_5V; PINHEAD1-2
P2: CONN_MP3Player; Wafer_Vertical22.5x5.8x7RM2.5-8
P3: LED_Bild1; PINHEAD1-2
P4: CONN_TASTER; PINHEAD1-2
P5: CONN_DREHENCODER; Wafer_Vertical15x5.8x7RM2.5-5
P6: CONN_DISPLAY; Wafer_Vertical22.5x5.8x7RM2.5-8
P7, P8: CONN_01X02; PINHEAD1-2
P9: CONN_OSC; Crystal_Round_Vertical_2mm
P10: LED_Bild2; PINHEAD1-2
P11: CONN_MP3; PINHEAD1-2
Q1, Q2: BC547; TO-92_Horizontal2_Inline_Narrow_Oval
R1, R2, R3, R4: 39; Resistor_Horizontal_RM10mm
R5, R6, R7: 10k; Resistor_Horizontal_RM15mm
R8, R9, R11, R13, R14: 220; Resistor_Horizontal_RM10mm
R10, R12: R; Resistor_Horizontal_RM10mm
U1: LM3940; TO-220
U2, U4: CBP
U3: LM317T; TO-220
U5: TDA7266_v4; Multiwatt_15_Vertical

Connections:
+5V: C1.1, P1.2, R10.2, R12.2, U1.1 (VI)
Amp-Mute: IC1.13 ((PCINT23/AIN1)PD7), R5.1
Amp-Power: IC1.14 ((PCINT0/CLKO/ICP1)PB0), R6.1
DE-A: C5.2, IC1.11 ((PCINT21/OC0B/T1)PD5), P5.2, R4.2
DE-B: C4.2, IC1.12 ((PCINT22/OC0A/AIN0)PD6), P5.3, R3.2
DE-C: C1.2, C2.2, C3.1, C6.1, C7.2, C8.2, C9.2, C10.2, IC1.8 (GND), IC1.22 (GND), P1.1, P2.8, P5.1, P6.7, Q1.3 (E), Q2.3 (E), R1.1, R2.1, R8.1, U1.2 (GND), U2.2 (-), U4.2 (-), U5.8 (GND), U5.9 (S-GND)
DE-D: C6.2, IC1.16 ((PCINT2/OC1B/~SS~)PB2), P5.4, R2.2
DE-E: C2.1, C4.1, C5.1, C9.1, C10.1, IC1.7 (VCC), IC1.20 (AVCC), IC1.21 (AREF), P4.2, P5.5, P6.8, R3.1, R4.1, U1.3 (VO), U3.3 (IN), U5.3 (Vcc), U5.13 (Vcc)
DISP-A0: IC1.25 ((PCINT10/ADC2)PC2), P6.3
DISP-CS1B: IC1.27 ((PCINT12/SDA/ADC4)PC4), P6.5
DISP-LED: IC1.28 ((PCINT13/SCL/ADC5)PC5), P6.6
DISP-RST: IC1.26 ((PCINT11/ADC3)PC3), P6.4
DISP-SCL: IC1.24 ((PCINT9/ADC1)PC1), P6.2
DISP-SI: IC1.23 ((PCINT8/ADC0)PC0), P6.1
LED-Bild1: IC1.17 ((PCINT3/OC2A/MOSI)PB3), R14.2
LED-Bild2: IC1.18 ((PCINT4/MISO)PB4), R13.2
MP3-L: C11.1, P11.1, U4.1 (+)
MP3-ON1: D1.2 (A), IC1.2 ((PCINT16/RXD)PD0)
MP3-R: C12.1, P11.2, U2.1 (+)
MP3-T1: IC1.4 ((PCINT18/INT0)PD2), P2.4
MP3-T3: IC1.3 ((PCINT17/TXD)PD1), P2.3
MP3-T4: IC1.5 ((PCINT19/OC2B/INT1)PD3), P2.5
MP3-T5: IC1.6 ((PCINT20/XCK/T0)PD4), P2.6
MP3-VCC: P2.7, R7.2, U3.2 (OUT)
unnamed: C7.1, R5.2, U5.6 (MUTE)
unnamed: C8.1, R6.2, U5.7 (ST-BY)
unnamed: C11.2, U5.12 (IN2+)
unnamed: C12.2, U5.4 (IN1+)
unnamed: D1.1 (K), D2.2 (A)
unnamed: D2.1 (K), D3.2 (A)
unnamed: D3.1 (K), P2.1
unnamed: IC1.9 ((PCINT6/XTAL1/TOSC1)PB6), P9.1
unnamed: IC1.10 ((PCINT7/XTAL2/TOSC2)PB7), P9.2
unnamed: P3.1, Q2.1 (C)
unnamed: P3.2, R12.1
unnamed: P10.1, Q1.1 (C)
unnamed: P10.2, R10.1
unnamed: Q1.2 (B), R9.1
unnamed: Q2.2 (B), R11.1
unnamed: R7.1, R8.2, U3.1 (ADJ)
unnamed: R11.2, R14.1
unnamed: R9.2, R13.1
SPK-L+: P8.1, U5.1 (OUT1+)
SPK-L-: P8.2, U5.2 (OUT1-)
SPK-R+: P7.1, U5.15 (OUT2+)
SPK-R-: P7.2, U5.14 (OUT2-)
T1.1: C3.2, IC1.15 ((PCINT1/OC1A)PB1), P4.1, R1.2

Notes on the sheet:
Spannungsregler 3,3V
Audio-Verstärker
Spannungsregler 1,5V
Connector Spannungsversorgung
Beleuchtung der Bilder

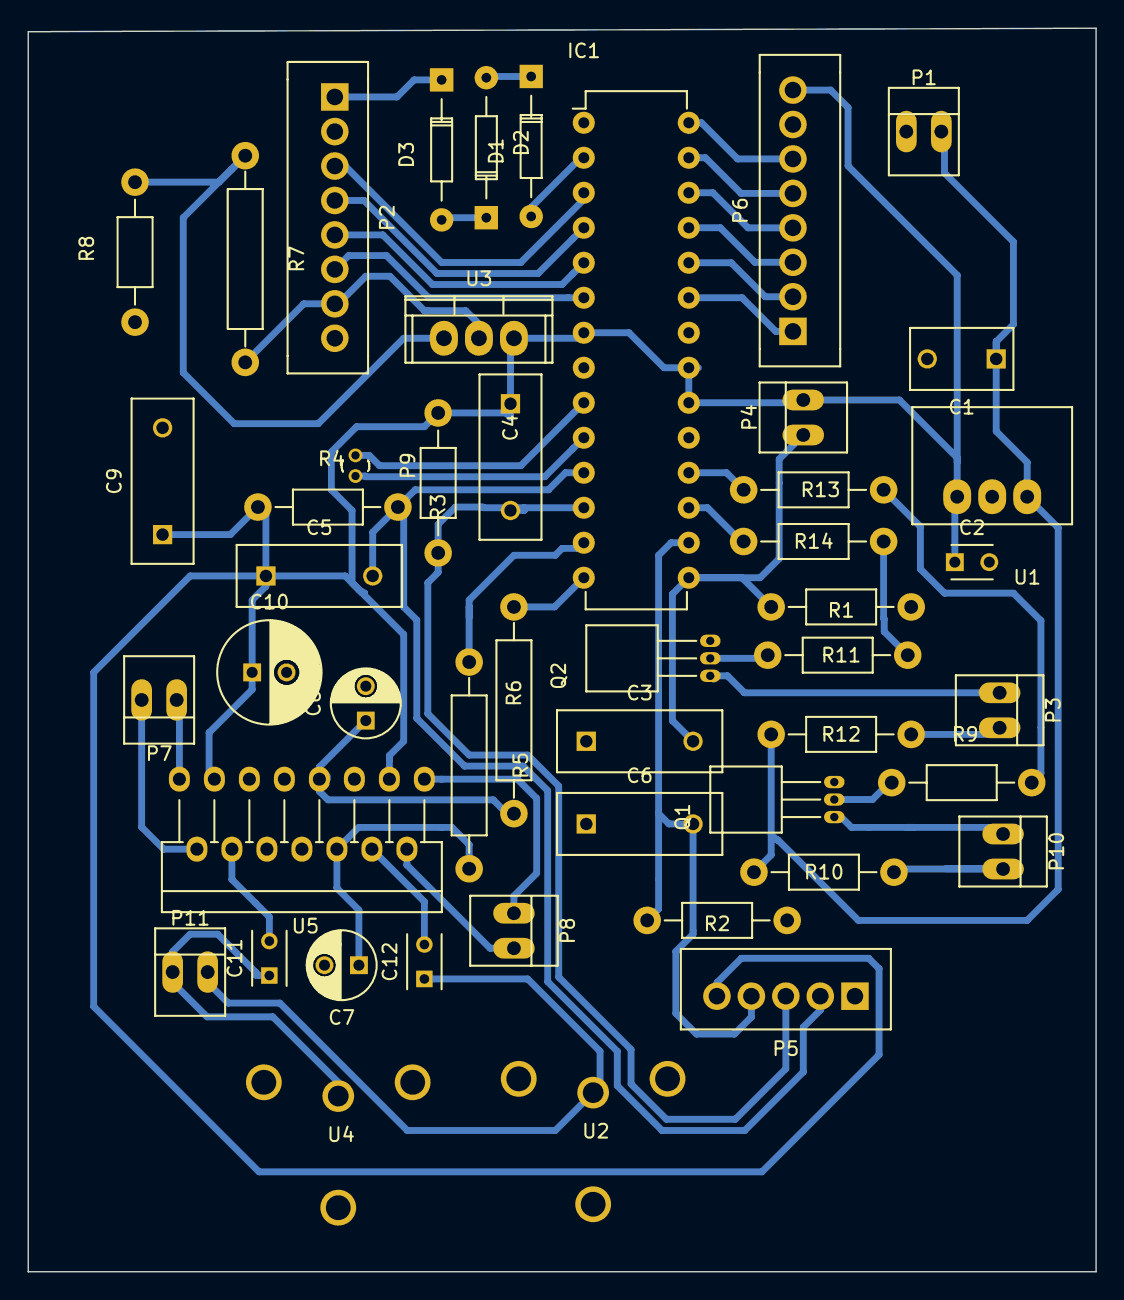
[picture p22: board Wecker.kicad_pcb from above]

Board: 2 copper layers, 77.5 x 90.2 mm, 48 parts (0 on the bottom side), 47 nets.
