MalteBastelt/Wecker/(commit log)

2015-10-24 Platinenlayout ausprobiert
    [Wecker.sch]
2015-10-24 Displayplatine Schematic erstellt
    [Display.kicad_pcb, Display.sch, Wecker.kicad_pcb, Wecker.sch]
2015-10-24 Footprints auf Displayplatine zugeordnet
    [Display.sch]
2015-10-24 Footprint EADOG korrigiert + Kondensatoren besserer Footprint
    [Display.sch]
2015-10-24 Bauteile auf Displayplatine geordnet
    [Display.kicad_pcb, _saved_Display.sch]
2015-10-25 Displayplatine fertig + EADOG Footprint korrigiert
    [Display.kicad_pcb, Display.sch, _saved_Display.sch]
2015-10-28 Displayplatine fertig
    [Display.kicad_pcb, Display.sch]
2015-10-28 Hauptplatine inkl TDA7266
    [Display.sch, Wecker.sch]
2015-11-28 Layout Hauptplatine2 v1. Mp3Player-On falsch
    [Wecker.kicad_pcb, Wecker.sch]
2015-11-28 PCB enger gepackt. MP3 Player in Code eingebunden.
    [Wecker.kicad_pcb, Wecker.sch]
2015-11-28 Haupptlatine2 fertig, Masseflächen vergrößert, Leiterbahnen zusammengeschoben
    [Wecker.kicad_pcb, Wecker.sch]
2015-11-29 Doku erweitert
    [Wecker.kicad_pcb]
2015-12-03 Doku fortgesetzt, Platine wurde hergestellt
    [Display.kicad_pcb, Wecker.kicad_pcb]
2015-12-12 Beleuchtung Plexiglas1 hinzugefügt
    [Wecker.sch]
2015-12-17 Ports LED-Bilder korrigiert und Beleuchtung aktiviert; Aufweckfunktion fertiggestellt
    [EADOGL128.c, EADOGL128.h, EADOGL128_commands.c, EADOGL128_commands.h, mp3.c, mp3.h]
2015-12-21 snooze fix. mp3 wieder auf alten mp3-Player umgestellt.
    [EADOGL128.c, EADOGL128.h, EADOGL128_commands.h, mp3.c]
2016-01-14 Code: Weckzeit durch snooze verändern fixed. Doku erweitert.
    [EADOGL128.c, EADOGL128.h, EADOGL128_commands.c, EADOGL128_commands.h]
